do7jbh/SSR-2/IMG_2501.JPG

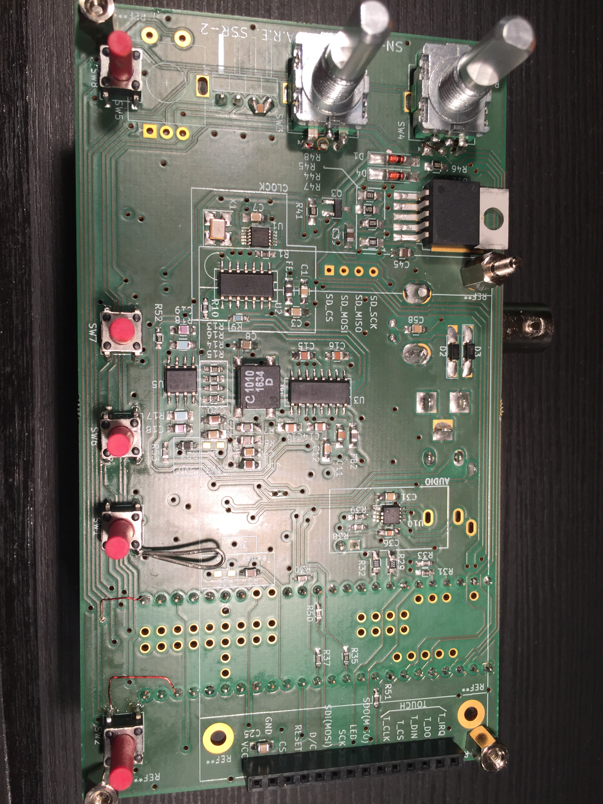
IMG_2501.JPG
