do7jbh/SSR-2/IMG_2545.JPG

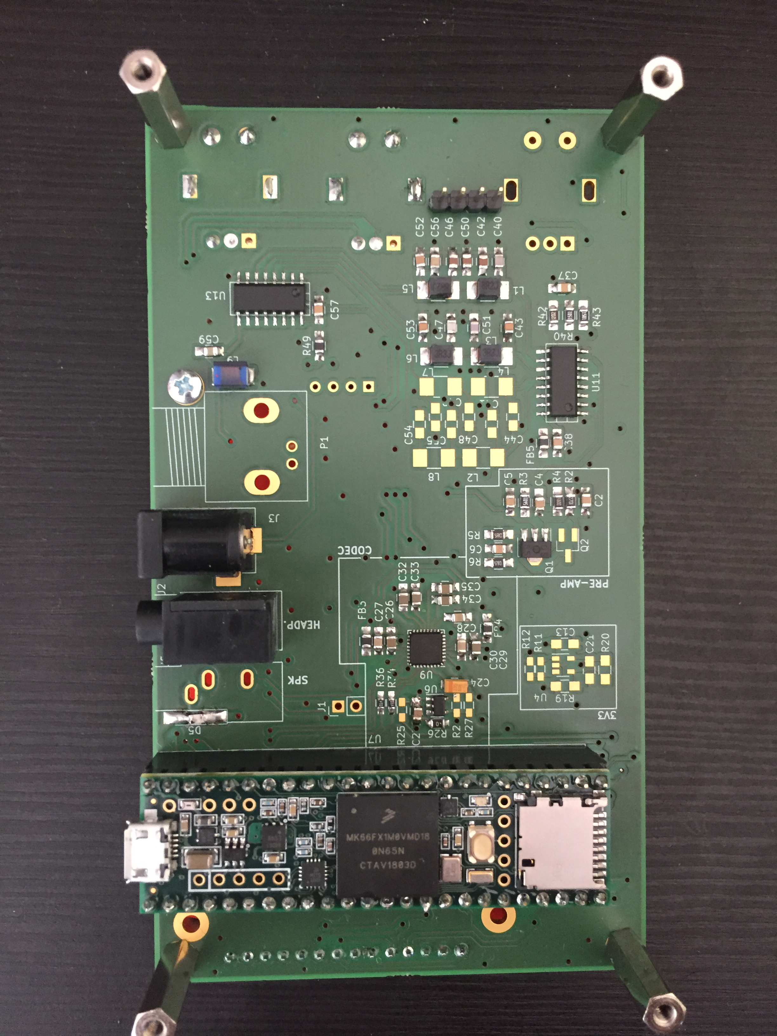
IMG_2545.JPG
