do7jbh/SSR-2/Blockdiagram-SSR-2.pdf

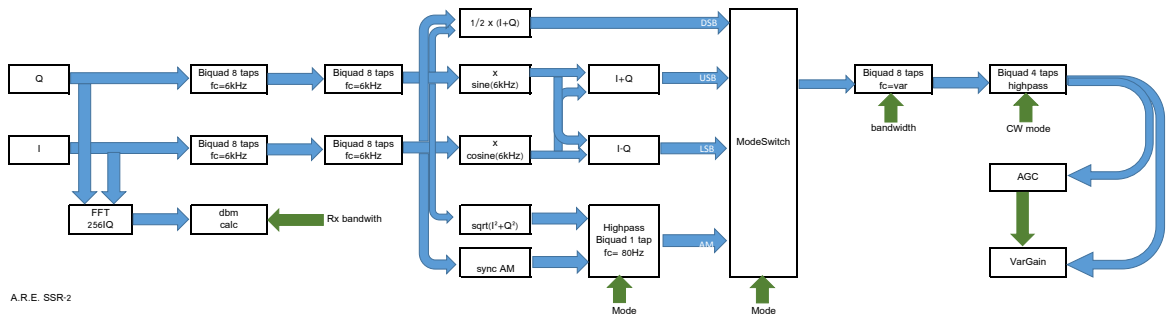
[picture p3: page 1]
Biquad 8 taps fc=6kHz; sine(6kHz); Biquad 8 taps fc=var; Biquad 4 taps highpass; bandwidth; CW mode; cosine(6kHz); AGC; FFT 256IQ; dbm; calc; Rx bandwith; sqrt(I²+Q²); sync AM; VarGain; A.R.E. SSR-2; Mode; ModeSwitch; Highpass Biquad 1 tap fc= 80Hz; DSB; USB; LSB
