do7jbh/SSR-2/AM_sync_demod.h

/* 
 * Copied from:
 * Audio Library for Teensy 3.X
 * Copyright (c) 2014, Paul Stoffregen, paul@pjrc.com
 *
 * Development of this audio library was funded by PJRC.COM, LLC by sales of
 * Teensy and Audio Adaptor boards.  Please support PJRC's efforts to develop
 * open source software by purchasing Teensy or other PJRC products.
 *
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
 * THE SOFTWARE IS PROVIDED "AS IS", WITHOUT WARRANTY OF ANY KIND, EXPRESS OR
 * IMPLIED, INCLUDING BUT NOT LIMITED TO THE WARRANTIES OF MERCHANTABILITY,
 * FITNESS FOR A PARTICULAR PURPOSE AND NONINFRINGEMENT. IN NO EVENT SHALL THE
 * AUTHORS OR COPYRIGHT HOLDERS BE LIABLE FOR ANY CLAIM, DAMAGES OR OTHER
 * LIABILITY, WHETHER IN AN ACTION OF CONTRACT, TORT OR OTHERWISE, ARISING FROM,
 * OUT OF OR IN CONNECTION WITH THE SOFTWARE OR THE USE OR OTHER DEALINGS IN
 * THE SOFTWARE.
 * Changed by Dante Bauer
 */

#ifndef am_sync_demod_h_
#define am_sync_demod_h_

#include "AudioStream.h"
#include "utility/dspinst.h"
#include "arm_math.h"

#define SAMPLE_RATE 96000

class AMDemodSync : public AudioStream
{
public:
	AMDemodSync() : AudioStream(2, inputQueueArray) { }
	virtual void update(void);
	void passthrough(bool p) {
	pass = p;}
	
	float read(void) {		
		return (float)delta_omega;
	}
	
private:
	audio_block_t *inputQueueArray[2];
	bool pass;
	float32_t delta_omega;
};

#endif
