do7jbh/SSR-2/display.h

// TFT stuff - change these defs for your specific LCD
#define BLACK   ILI9341_BLACK
#define WHITE   ILI9341_WHITE
#define RED     ILI9341_RED
#define GREEN   ILI9341_GREEN
#define YELLOW  ILI9341_YELLOW
#define BLUE    ILI9341_BLUE
#define LGREEN	0x03E0
#define LBLUE   0xAF9F

/*
#define LSB_18 0
#define USB_18 1
#define AM_18 2
#define LSB_26 3
#define USB_26 4
#define AM_26 5
#define LSB_36 6
#define USB_36 7
#define AM_36 8
#define LSB_44 9
#define USB_44 10
#define AM_44 11
#define LSB_65 12
#define USB_65 13
#define AM_65 14
#define LSB_80 15
#define USB_80 16
#define AM_80 17
#define LSB_80_90 18
#define USB_80_90 19
#define AM_80_90 20
*/
