do7jbh/SSR-2/iir_110_96ks.h

// DC - 5.4 kHz
// sampling rate 96 kHz
// Parameters generated using Iowa Hills IIR Filter Designer
// 8th order elliptic (4-stage cascaded biquad)
// -50dB
// 
// coefficients must be in order: B0. B1. B2. A1. A0
const double IIR_110_96k_Coeffs_0[] =
{  

0.461208931569485281,
-0.47342798358297100,
0.461208931569485281,
-0.68046320732135989,
0.129453086877359541
};
const double IIR_110_96k_Coeffs_1[] =
{  

0.351822057565500446,
-0.26853339057496739,
0.351822057565500446,
-0.84968869510023681,
0.284799419656270314
};
const double IIR_110_96k_Coeffs_2[] =
{  

0.213892428071867702,
0.000526563613199619,
0.213892428071867702,
-1.10127450147819173,
0.529585921235126822
};
const double IIR_110_96k_Coeffs_3[] =
{  

0.127784450833260038,
0.199582767194177640,
0.127784450833260038,
-1.36930935793757635,
0.824461026798274044
};
