do7jbh/SSR-2/iir_18_96ks.h

// SSR 2 DO7JBH
// 1.8 kHz Filter 
// coefficients must be in order: B0. B1. B2. A1. A2
// -60 dB Stoppband
// -2dB  1800Hz 
// -62dB 2000Hz
// fs = 96k
// 8th order eliptic filter


const double IIR_18_96k_Coeffs_0[] =
{
0.111660385236935139  ,
-0.221383805051339477 ,
0.111660385236935139  ,
-1.942541983870671900 ,
0.944478949293202752
};
const double IIR_18_96k_Coeffs_1[] =
{
0.364292525727489491  ,
-0.721178659532659694 ,
0.364292525727489491  ,
-1.960045935898491630 ,
0.967452327820811142
};
const double IIR_18_96k_Coeffs_2[] =
{
0.343767305648670751  ,
-0.675703530515683215 ,
0.343767305648670751  ,
-1.974801588188375370 ,
0.986632668970033655
};
const double IIR_18_96k_Coeffs_3[] =
{
0.064398383879282248  ,
-0.115117641908953280 ,
0.064398383879282248  ,
-1.982951098343989970 ,
0.996630224193601144
};
