do7jbh/SSR-2/iir_23_96ks.h

// SSR 2 DO7JBH
// 2.3 kHz Filter 
// coefficients must be in order: B0. B1. B2. A1. A2
// -60 dB Stoppband
// -2.3dB  2300Hz 
// -62dB  2550Hz
// fs = 96k
// 8th order eliptic filter


const double IIR_23_96k_Coeffs_0[] =
{  
0.111076685085215468  ,
-0.219017190623605501 ,
0.111076685085215468  ,
-1.926497528706887060 ,
0.929633708253712388
};
const double IIR_23_96k_Coeffs_1[] =
{  
0.363396303946344479  ,
-0.714773063099388484 ,
0.363396303946344479  ,
-1.946634864432382090 ,
0.958654409225682458
};
const double IIR_23_96k_Coeffs_2[] =
{  
0.344354330431608513  ,
-0.669470922567804383 ,
0.344354330431608513  ,
-1.963748426026876490 ,
0.982986164322289246
};
const double IIR_23_96k_Coeffs_3[] =
{  
0.066385451735610834  ,
-0.110503882875847545 ,
0.066385451735610834  ,
-1.973439269372833320 ,
0.995706289968207536
};
