do7jbh/SSR-2/iir_26_96ks.h

// SSR 2 DO7JBH
// 2.6 kHz Filter 
// coefficients must be in order: B0. B1. B2. A1. A2
// -60 dB Stoppband
// -2.0dB  2600Hz 
// -60dB   2880Hz
// fs = 96k
// 8th order eliptic filter
const double IIR_26_96k_Coeffs_0[] =
{  
0.110758855771068268    ,
-0.217519418332049935   ,
0.110758855771068268    ,
-1.916742652084194140   ,
0.920740945294280633
};
const double IIR_26_96k_Coeffs_1[] =
{  
0.362945090031146334   ,
-0.710546865783574622  ,
0.362945090031146334   ,
-1.938026100620916070  ,
0.953369414899633894
};
const double IIR_26_96k_Coeffs_2[] =
{  
0.344853201967403655   ,
-0.665121976660508207  ,
0.344853201967403655   ,
-1.956205950712500470  ,
0.980790377986799688
};
const double IIR_26_96k_Coeffs_3[] =
{  
0.067824872519840582  ,
-0.107176343639967544 ,
0.067824872519840582  ,
-1.966675719463476520 ,
0.995149120863190073
};
