do7jbh/SSR-2/iir_28_96ks.h

// SSR 2 DO7JBH
// 2.8 kHz Filter 
// coefficients must be in order: B0. B1. B2. A1. A2
// -60 dB Stoppband
// -2.9dB  2800Hz 
// -62dB   3080Hz
// fs = 96k
// 8th order eliptic filter
const double IIR_28_96k_Coeffs_0[] =
{ 
 0.117813180745773349  ,
 -0.230827810649719217 ,
 0.117813180745773349  ,
 -1.908779851238202150 ,
 0.913578402080029717
};
const double IIR_28_96k_Coeffs_1[] =
{ 
0.383352039913785192   ,
-0.748561705162836932  ,
0.383352039913785192   ,
-1.932245562745495530  ,
0.950387937410228867 
};
const double IIR_28_96k_Coeffs_2[] =
{ 
0.364530814512189938   ,
-0.700416940871572691  ,
0.364530814512189938   ,
-1.951528365243801580  ,
0.980173053396608873
};
const double IIR_28_96k_Coeffs_3[] =
{ 
 0.072747608303844816  ,
-0.112567480582466420  ,
0.072747608303844816   ,
-1.962167753145843680  ,
0.995095489171066938 
};
