do7jbh/SSR-2/iir_33_96ks.h

// SSR 2 DO7JBH
// 3.6 kHz Filter 
// coefficients must be in order: B0. B1. B2. A1. A2
// -60 dB Stoppband
// -2.0dB  2600Hz 
// -60dB   2880Hz
// fs = 96k
// 8th order eliptic filter
const double IIR_33_96k_Coeffs_0[] =
{ 
 0.117317819172365959  ,
-0.228015674814741165  ,
 0.117317819172365959  ,
-1.892287882807285990  ,
 0.898907846337276717 
};
const double IIR_33_96k_Coeffs_1[] =
{ 
0.382743448454548163  ,
-0.740408441621354330 ,
0.382743448454548163  ,
-1.916772364758938970 ,
0.941850820046680859 
};
const double IIR_33_96k_Coeffs_2[] =
{ 
0.365656397968172286  ,
-0.691652012551390416 ,
0.365656397968172286  ,
-1.937062448125970390 ,
0.976723231510924550  
};
const double IIR_33_96k_Coeffs_3[] =
{ 
0.075688738937866887  ,
-0.105744704523884625 ,
0.075688738937866887  ,
-1.948604070974641940 ,
0.994236844326491065 
};
