do7jbh/SSR-2/iir_36_96ks.h

// SSR 2 DO7JBH
// 3.6 kHz Filter 
// coefficients must be in order: B0. B1. B2. A1. A2
// -60 dB Stoppband
// -2.5dB  3600Hz 
// -59dB   3980Hz
// fs = 96k
// 8th order eliptic filter

const double IIR_36_96k_Coeffs_0[] =
{  
 0.109896934721394016  ,
-0.212234283868813961  ,
 0.109896934721394016  ,
-1.884330390985038410  ,
 0.891889976559012254 
};
const double IIR_36_96k_Coeffs_1[] =
{
 0.361941617430894314  ,
 -0.694767968703195682 ,
 0.361941617430894314  ,
 -1.907048659241632690 ,
 0.936163925400225638  
};
const double IIR_36_96k_Coeffs_2[] =
{
 0.347261665195358837   ,
 -0.647725950354574809  ,
 0.347261665195358837   ,
 -1.926822668709112340  ,
 0.973620048745255207 
};
const double IIR_36_96k_Coeffs_3[] =
{
 0.073830180995771613   ,
 -0.093359227984691123  ,
 0.073830180995771613   ,
 -1.939024904020461900  ,
 0.993326038027313896  
};
