do7jbh/SSR-2/iir_40_96ks.h

// SSR 2 DO7JBH
// 4.0 kHz Filter 
// coefficients must be in order: B0. B1. B2. A1. A2
// -60 dB Stoppband
// -2.8dB  4000Hz 
// -62dB   4430Hz
// fs = 96k
// 8th order eliptic filter
const double IIR_40_96k_Coeffs_0[] =
{  
0.109631828448286880  ,
-0.209980635202030835 ,
0.109631828448286880  ,
-1.871302251208534660 ,
0.880585272903077643
};

const double IIR_40_96k_Coeffs_1[] =
{  
0.361747679867919003  ,
-0.687699643106521208 ,
0.361747679867919003  ,
-1.893608782880328520 ,
0.929404499509645432
};
const double IIR_40_96k_Coeffs_2[] =
{  
0.348546274306103854  ,
-0.639497457835439542 ,
0.348546274306103854  ,
-1.913201169625379010 ,
0.970796260402147282
};
const double IIR_40_96k_Coeffs_3[] =
{  
0.076758713861301162 ,
-0.086643382581708797,
0.076758713861301162 ,
-1.925732746028522510,
0.992606791169416081
};
