do7jbh/SSR-2/iir_44_96ks.h

// SSR 2 DO7JBH
// 4.4 kHz Filter 
// coefficients must be in order: B0. B1. B2. A1. A2
// -60 dB Stoppband
// -2.5dB  4400Hz 
// -60dB   4860Hz
// fs = 96k
// 8th order eliptic filter
const double IIR_44_96k_Coeffs_0[] =
{  
0.109408526386298305  ,
-0.207616230012989844 ,
0.109408526386298305  ,
-1.858058282515735240 ,
0.869259105275342003
};
const double IIR_44_96k_Coeffs_1[] =
{  
0.361670275976515465   ,
-0.680103784346817952  ,
0.361670275976515465   ,
-1.879389743338290670  ,
0.922626510944503653
};
const double IIR_44_96k_Coeffs_2[] =
{  
0.350032489439781991  ,
-0.630431974028966780 ,
0.350032489439781991  ,
-1.898329309240097460 ,
0.967962314090694775
};
const double IIR_44_96k_Coeffs_3[] =
{  
0.080028357786688306  ,
-0.079155812515603843 ,
0.080028357786688306  ,
-1.910983476047470650 ,
0.991884379105243297
};
