do7jbh/SSR-2/iir_54_96ks.h

// SSR 2 DO7JBH
// 5.4 kHz Filter 
// coefficients must be in order: B0. B1. B2. A1. A2
// -60 dB Stoppband
// -2.5dB  54000Hz 
// -64dB   5980Hz
// fs = 96k
// 8th order eliptic filter
const double IIR_54_96k_Coeffs_0[] =
{  
0.109047662539606877   ,
-0.201400109336255712  ,
0.109047662539606877   ,
-1.824990325535017940  ,
0.841685541277976013 
};
const double IIR_54_96k_Coeffs_1[] =
{  
 0.361989223750267319 ,
-0.659403211024745528 ,
 0.361989223750267319 ,
-1.841545000395464760 ,
 0.906120236871253870 
};
const double IIR_54_96k_Coeffs_2[] =
{  
0.354510148575579442  ,
-0.604833150793405938 ,
0.354510148575579442  ,
-1.856870054647475010 ,
 0.961057201005228068
};
const double IIR_54_96k_Coeffs_3[] =
{  
0.089432443943173692  ,
-0.057661453072439237 ,
0.089432443943173692  ,
-1.868918990391342790 ,
0.990122425205250956
};
