do7jbh/SSR-2/iir_60_96ks.h

// DC - 5.4 kHz
// -60 6kHz
// -3dB 180Hz
// -0.15dB 300Hz
// sampling rate 96 kHz
// Parameters generated using Iowa Hills IIR Filter Designer
// 8th order elliptic (4-stage cascaded biquad)
// -44dB
// DO7JBH SSR-2
// coefficients must be in order: B0. B1. B2. A1. A0
const double IIR_60_96k_Coeffs_0[] =
{  

0.191223967324453042   ,
-0.353297138349801532  ,
0.191223967324453042   ,
-1.771454804875047810  ,
 0.800605601174152470
};
const double IIR_60_96k_Coeffs_1[] =
{  

0.571105112172129004   ,
-1.047449773476589520  ,
0.571105112172129004   ,
-1.817201920485548070  ,
0.911962371353216561
};
const double IIR_60_96k_Coeffs_2[] =
{  

0.552586659604062613    ,
-0.974003152742314193   ,
0.552586659604062613    ,
-1.843084782586313030   ,
 0.974254949052124175
};
const double IIR_60_96k_Coeffs_3[] =
{  
0.138772337944061519    ,
-0.135558030703281096   ,
0.138772337944061519    ,
-1.852885979491437410   ,
0.994872624676279349
};
