do7jbh/SSR-2/iir_65_96ks.h

// DC - 6.5 kHz
// sampling rate 96 kHz
// Parameters generated using Iowa Hills IIR Filter Designer
// 8th order elliptic (4-stage cascaded biquad)
// -50dB
// 
// coefficients must be in order: B0. B1. B2. A1. A0
const double IIR_65_96k_Coeffs_0[] =
{  

0.521455938342938463,
-0.84140799055905068,
0.521455938342938463,
-1.12089485956103907,
0.322398745687865196
};
const double IIR_65_96k_Coeffs_1[] =
{  

0.359816320819206337,
-0.53321680247558112,
0.359816320819206337,
-1.28215420942541236,
0.468570048588243915
};
const double IIR_65_96k_Coeffs_2[] =
{  

0.171803114064475682,
-0.17182681467919672,
0.171803114064475682,
-1.50101032141880353,
0.672789734868558309
};
const double IIR_65_96k_Coeffs_3[] =
{  

0.058435991283826400,
0.053744802247773470,
0.058435991283826400,
-1.71525991685026136,
0.885876701665687660
};
