do7jbh/SSR-2/iir_80_96ks.h

// DC - 8 kHz
// sampling rate 96 kHz
// Parameters generated using Iowa Hills IIR Filter Designer
// 8th order elliptic (4-stage cascaded biquad)
// -50dB
// 
// coefficients must be in order: B0. B1. B2. A1. A0
const double IIR_80_96k_Coeffs_0[] =
{  

0.494811691964573364,
-0.70979800272069837,
0.494811691964573364,
-0.96186028297688042,
0.241685664185328664
};
const double IIR_80_96k_Coeffs_1[] =
{  

0.353457621825825019,
-0.44337418817407142,
0.353457621825825019,
-1.13100252880249652,
0.394543584280075021
};
const double IIR_80_96k_Coeffs_2[] =
{  

0.183498632217834079,
-0.11807546031215070,
0.183498632217834079,
-1.36896667557331098,
0.617888479696828363
};
const double IIR_80_96k_Coeffs_3[] =
{  

0.078570727834323853,
0.096253049604959645,
0.078570727834323853,
-1.61001479127153369,
0.863409296545141092
};
