do7jbh/SSR-2/iir_highpass_96ks.h

// SSR 2 DO7JBH
// highpass for AM
// coefficients must be in order: B0. B1. B2. A1. A2
const double IIR_highpass_96k_Coeffs_0[] =
{  
0.999685939389359679    ,
-0.999685939389359679   ,
0.000000000000000000    ,
-0.999371878778719136   ,
0.000000000000000000
 };
 
